PUT-Motorsport/PUTM_EV_DRS_2025/README.md

# PUTM_EV_DRS_2024
 Drs (active aero) project for PUT Motorsport
