PUT-Motorsport/PUTM_EV_DRS_2025/documentation/STM-pinout.png

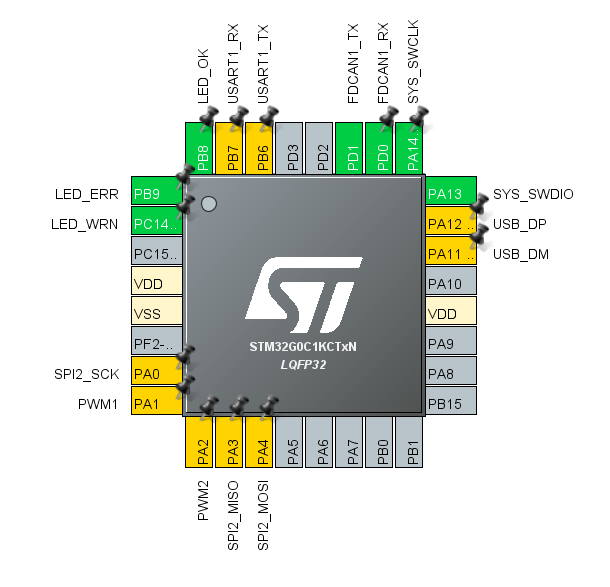
documentation/STM-pinout.png
