PUT-Motorsport/PUTM_EV_DRS_2025/documentation/WBDesignSpec_5V.png

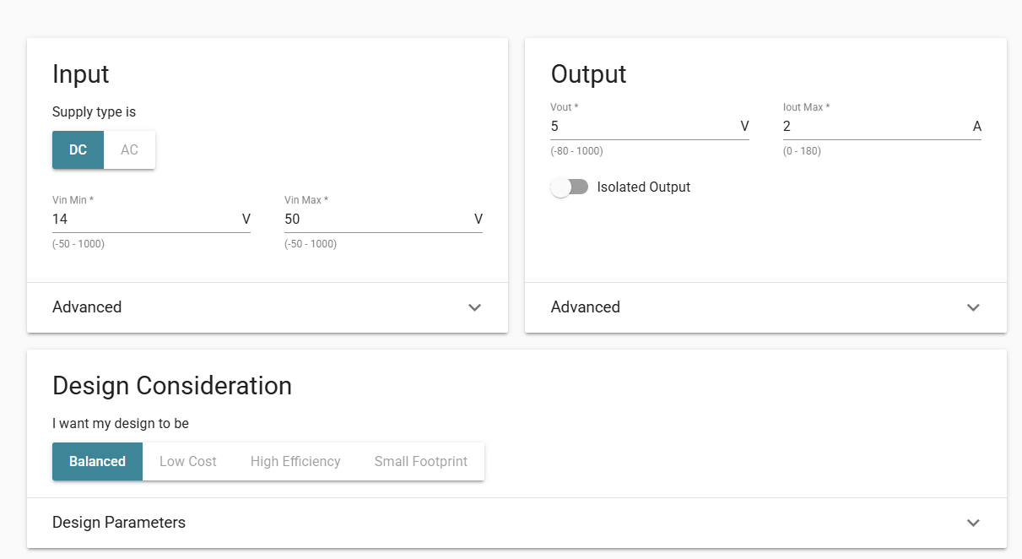
documentation/WBDesignSpec_5V.png
