PUT-Motorsport/PUTM_EV_DRS_2025/documentation/WBDesignSpec_6V6.png

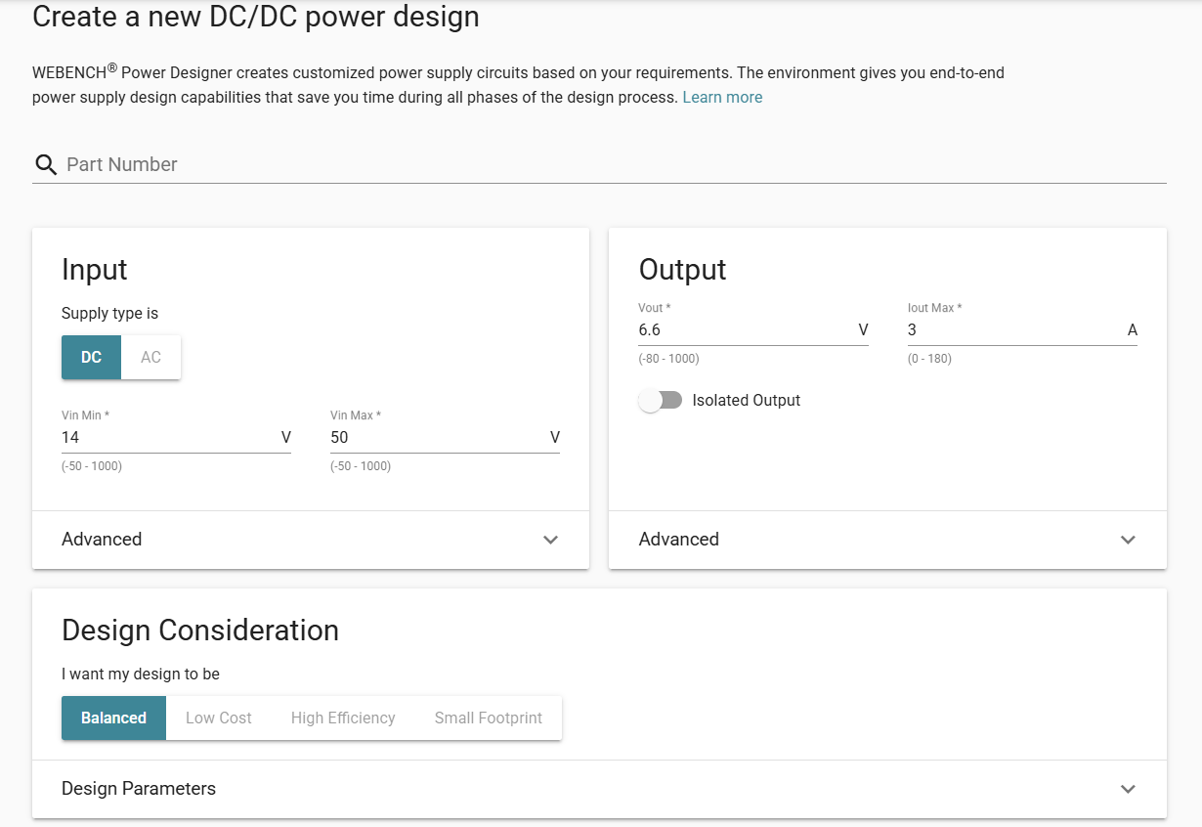
documentation/WBDesignSpec_6V6.png
