PUT-Motorsport/PUTM_EV_DRS_2025/documentation/WBBOMDesignLMR51635DDC.csv

Part | Manufacturer | Part Number | Quantity | Price ($) | Footprint (mm²) | Description
Cout | MuRata | GRM32ER61C476KE15L | 2 | 0.17 | 14.7 | Cap: 47 µF Total Derated Cap: 51 µF VDC: 16 V ESR: 3.04 mΩ Package: 1210
Cinx | MuRata | GRM188R72A104KA35D | 1 | 0.04 | 4.68 | Cap: 100 nF Total Derated Cap: 48 nF VDC: 100 V ESR: 1 mΩ Package: 0603
L1 | Bourns | SRR1208-120ML | 1 | 0.56 | 216.09 | L: 12 µH DCR: 25 mΩ IDC: 6.5 A
U1 | Texas Instruments | LMR51635DDC | 1 | 0.7 | 10.14
Cboot | MuRata | GRM155R71C104KA88D | 1 | 0.01 | 3 | Cap: 100 nF Total Derated Cap: 100 nF VDC: 16 V ESR: 1 mΩ Package: 0402
Cin | TDK | C3216X7R2A105K160AA | 3 | 0.11 | 10.92 | Cap: 1 µF Total Derated Cap: 1.5 µF VDC: 100 V ESR: 4.58 mΩ Package: 1206_180
Rfbb | Vishay-Dale | CRCW060313K7FKEA | 1 | 0.01 | 4.68 | Resistance: 13.7 kΩ Tolerance: 1.0% Power: 100 mW
Rfbt | Vishay-Dale | CRCW0402100KFKED | 1 | 0.01 | 3 | Resistance: 100 kΩ Tolerance: 1.0% Power: 63 mW
