PUT-Motorsport/PUTM_EV_DRS_2025/hardware/drs.kicad_pcb

## KiCad design hardware/drs.kicad_pcb (2025-05-21)

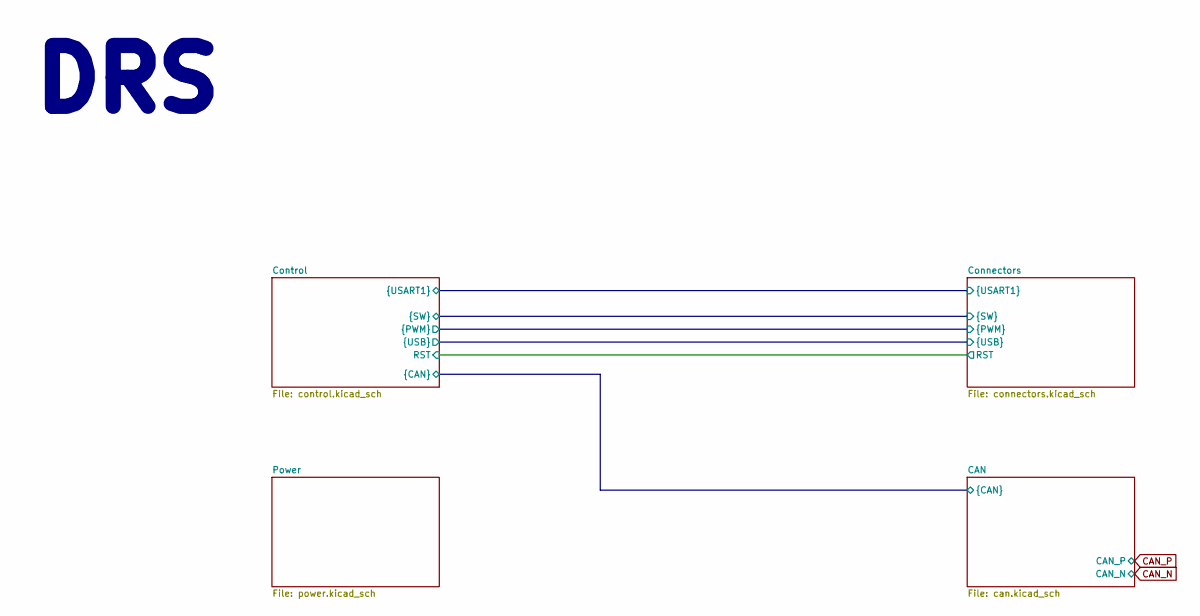
[picture p4: schematic drs.kicad_sch, DRS - Drag Reduction System]

Notes on the sheet:
DRS

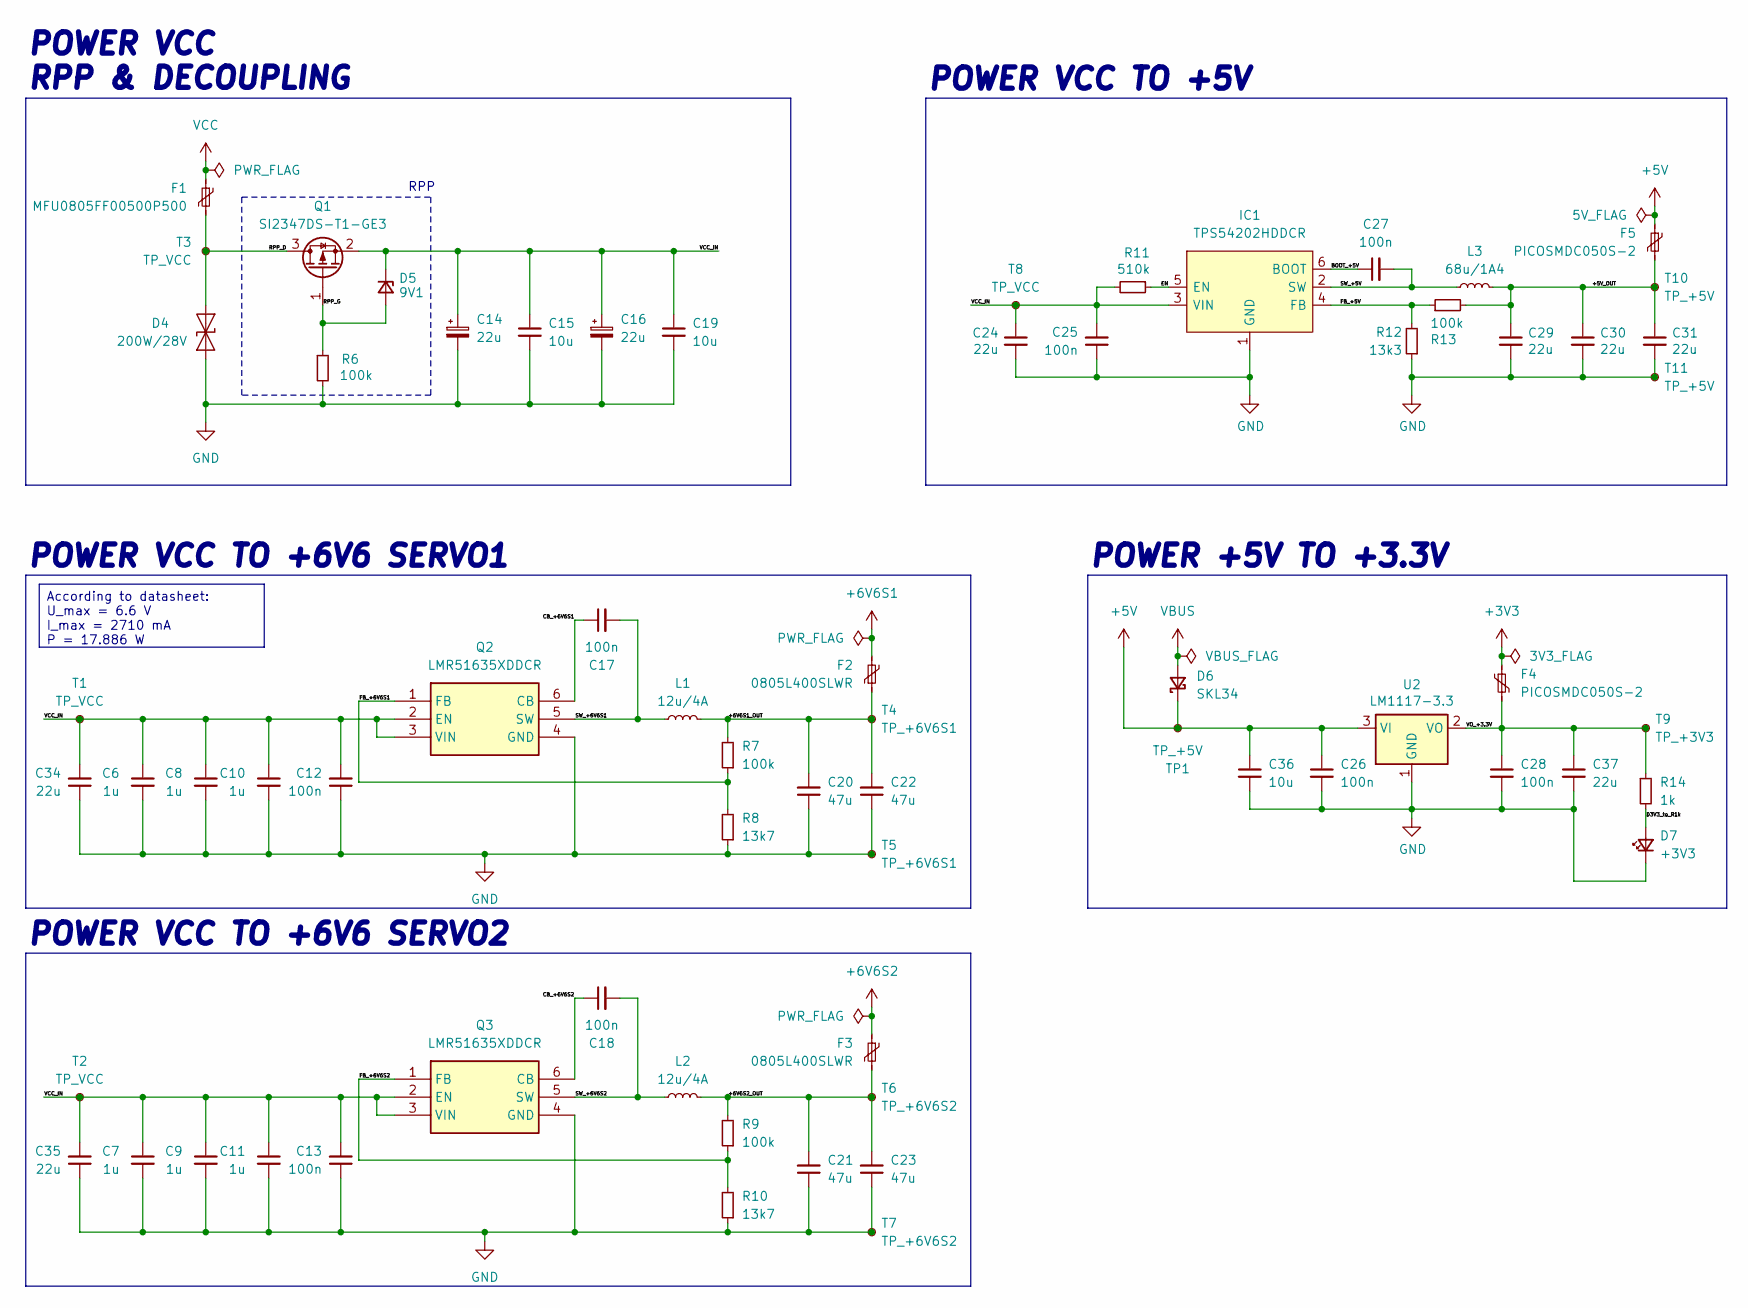
[picture p5: schematic power.kicad_sch, DRS - Drag Reduction System]

Parts:
C6, C7, C8, C9, C10, C11: 1u; C_0603_1608Metric_Pad1.08x0.95mm_HandSolder
C12, C13, C17, C18, C26, C27, C28: 100n; C_0603_1608Metric_Pad1.08x0.95mm_HandSolder
C14, C16: 22u; CP_Elec_4x5.8
C15, C19, C36: 10u; C_0603_1608Metric_Pad1.08x0.95mm_HandSolder
C20, C21, C22, C23: 47u; C_0805_2012Metric_Pad1.18x1.45mm_HandSolder
C24, C29, C30, C31: 22u; C_0805_2012Metric_Pad1.18x1.45mm_HandSolder; Manufacturer_Part_Number CL21A107MQYNNWE; Mouser Part Number 810-C2012X5R1V226MAC
C25: 100n; C_0603_1608Metric_Pad1.08x0.95mm_HandSolder; Manufacturer_Part_Number C0603C104J3RACTU; Mouser Part Number 80-C0603C104J3R
C34, C35, C37: 22u; C_0805_2012Metric_Pad1.18x1.45mm_HandSolder
D4: 200W/28V; D_SOD-123
D5: 9V1; D_SOD-323_HandSoldering
D6: SKL34; D_SOD-123F
D7: +3V3; LED_0603_1608Metric_Pad1.05x0.95mm_HandSolder
F1: MFU0805FF00500P500; Fuse_0805_2012Metric_Pad1.15x1.40mm_HandSolder
F2, F3: 0805L400SLWR; Fuse_0805_2012Metric_Pad1.15x1.40mm_HandSolder
F4, F5: PICOSMDC050S-2; Fuse_0805_2012Metric_Pad1.15x1.40mm_HandSolder
IC1: TPS54202HDDCR; SOT-23-6_Handsoldering; Mouser Part Number 595-TPS54202HDDCR
L1, L2: 12u/4A; L_Bourns_SRN6045TA
L3: 68u/1A4; L_TDK_VLS6045EX_VLS6045AF; Mouser Part Number 810-VLS6045EX-680M
Q1: SI2347DS-T1-GE3; SOT-23-3
Q2, Q3: LMR51635XDDCR; SOT-23-6_Handsoldering; Manufacturer_Part_Number LMR51635XDDCR
R6, R7, R9: 100k; R_0603_1608Metric_Pad0.98x0.95mm_HandSolder
R8, R10: 13k7; R_0603_1608Metric_Pad0.98x0.95mm_HandSolder
R11: 510k; R_0603_1608Metric_Pad0.98x0.95mm_HandSolder; Manufacturer_Part_Number RT0603DRD07510KL; Mouser Part Number 603-RT0603DRD07510KL
R12: 13k3; R_0603_1608Metric_Pad0.98x0.95mm_HandSolder; Manufacturer_Part_Number RT0603DRE0713K3L; Mouser Part Number 603-RT0603DRE0713K3L
R13: 100k; R_0603_1608Metric_Pad0.98x0.95mm_HandSolder; Manufacturer_Part_Number RT0603DRE07100KL; Mouser Part Number 603-RT0603DRE07100KL
R14: 1k; R_0603_1608Metric_Pad0.98x0.95mm_HandSolder
T1, T2, T3, T8: TP_VCC; TestPoint_Pad_1.0x1.0mm
T4, T5: TP_+6V6S1; TestPoint_Pad_1.0x1.0mm
T6, T7: TP_+6V6S2; TestPoint_Pad_1.0x1.0mm
T9: TP_+3V3; TestPoint_Pad_1.0x1.0mm
T10, T11: TP_+5V; TestPoint_Pad_1.0x1.0mm
TP1: TP_+5V; TestPoint_Pad_1.0x1.0mm
U2: LM1117-3.3; SOT-223-3_TabPin2

Connections:
+3V3: F4.1; also elsewhere on the board
+5V: C26.1, C36.1, D6.1 (K), F5.1, TP1.1, U2.3 (VI); also elsewhere on the board
+6V6S1: F2.2; also elsewhere on the board
+6V6S2: F3.1; also elsewhere on the board
/Power/+5V_OUT: C29.1, C30.1, C31.1, F5.2, L3.2, R13.2, T10.1
/Power/+6V6S1_OUT: C20.2, C22.2, F2.1, L1.2, R7.2, T4.1
/Power/+6V6S2_OUT: C21.2, C23.2, F3.2, L2.2, R9.2, T6.1
/Power/BOOT_+5V: C27.1, IC1.6 (BOOT)
/Power/CB_+6V6S1: C17.1, Q2.6 (CB)
/Power/CB_+6V6S2: C18.1, Q3.6 (CB)
/Power/D3V3_to_R1k: D7.2 (A), R14.2
/Power/EN: IC1.5 (EN), R11.1
/Power/FB_+5V: IC1.4 (FB), R12.2, R13.1
/Power/FB_+6V6S1: Q2.1 (FB), R7.1, R8.2
/Power/FB_+6V6S2: Q3.1 (FB), R9.1, R10.2
/Power/RPP_D: D4.2 (A2), F1.2, Q1.3 (D), T3.1
/Power/RPP_G: D5.2 (A), Q1.1 (G), R6.1
/Power/SW_+5V: C27.2, IC1.2 (SW), L3.1
/Power/SW_+6V6S1: C17.2, L1.1, Q2.5 (SW)
/Power/SW_+6V6S2: C18.2, L2.1, Q3.5 (SW)
/Power/VCC_IN: C6.1, C7.1, C8.1, C9.1, C10.1, C11.1, C12.2, C13.2, C14.1, C15.1, C16.1, C19.1, C24.1, C25.2, C34.2, C35.2, D5.1 (K), IC1.3 (VIN), Q1.2 (S), Q2.2 (EN), Q2.3 (VIN), Q3.2 (EN), Q3.3 (VIN), R11.2, T1.1, T2.1, T8.1
/Power/VO_+3.3V: C28.1, C37.1, F4.2, R14.1, T9.1, U2.2 (VO)
GND: C6.2, C7.2, C8.2, C9.2, C10.2, C11.2, C12.1, C13.1, C14.2, C15.2, C16.2, C19.2, C20.1, C21.1, C22.1, C23.1, C24.2, C25.1, C26.2, C28.2, C29.2, C30.2, C31.2, C34.1, C35.1, C36.2, C37.2, D4.1 (A1), D7.1 (K), IC1.1 (GND), Q2.4 (GND), Q3.4 (GND), R6.2, R8.1, R10.1, R12.1, T5.1, T7.1, T11.1, U2.1 (GND); also elsewhere on the board
VBUS: D6.2 (A); also elsewhere on the board
VCC: F1.1; also elsewhere on the board

Notes on the sheet:
RPP
POWER VCC TO +6V6 SERVO2
POWER VCC TO +5V
POWER +5V TO +3.3V
POWER VCC RPP & DECOUPLING
POWER VCC TO +6V6 SERVO1
According to datasheet: U_max = 6.6 V I_max = 2710 mA P = 17.886 W

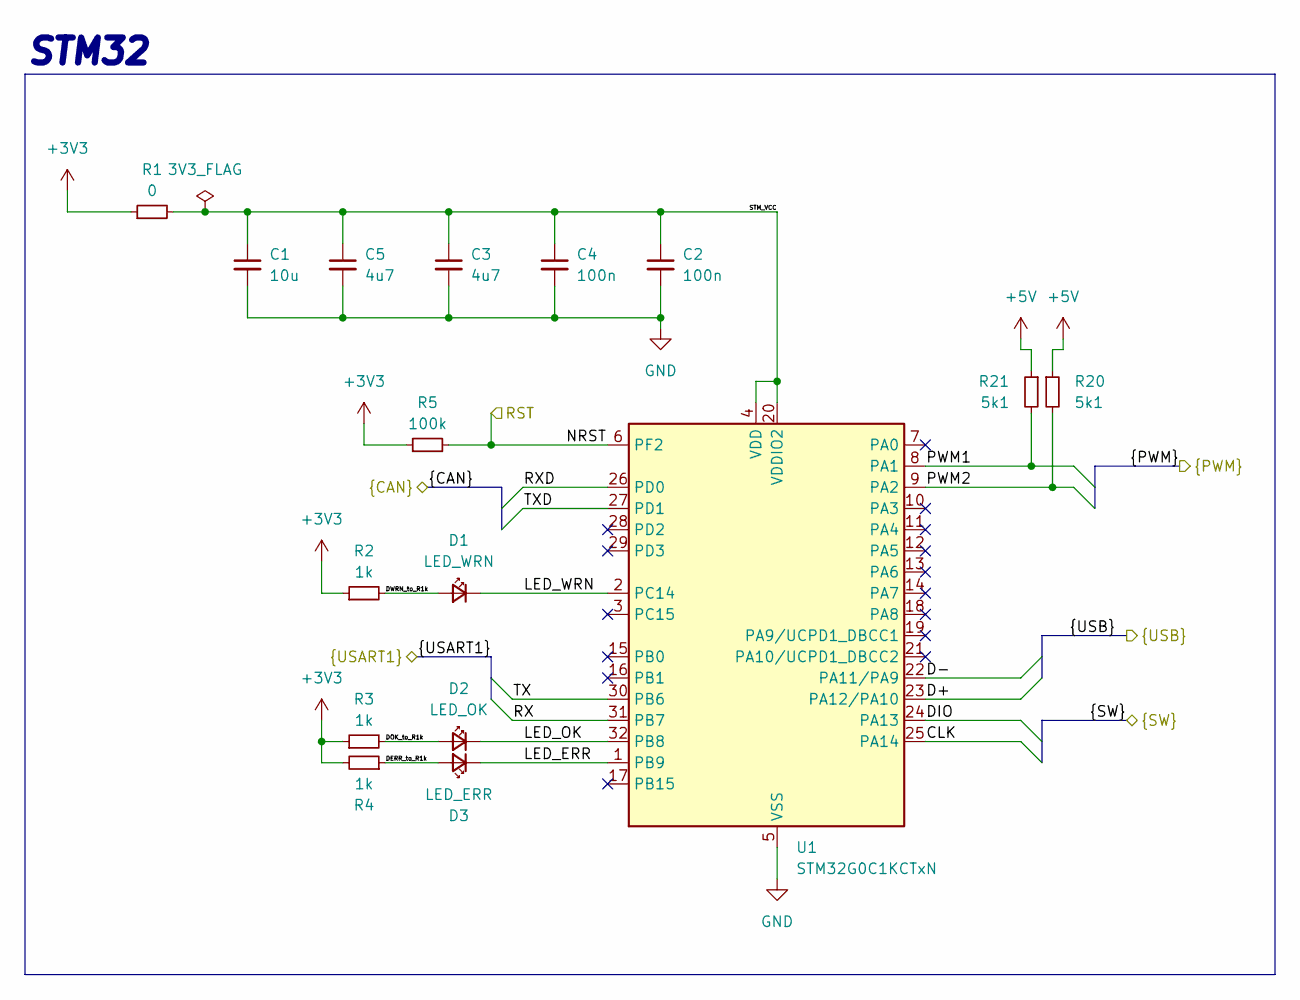
[picture p6: schematic control.kicad_sch, DRS - Drag Reduction System]

Parts:
C1: 10u; C_0603_1608Metric_Pad1.08x0.95mm_HandSolder
C2, C4: 100n; C_0603_1608Metric_Pad1.08x0.95mm_HandSolder
C3, C5: 4u7; C_0603_1608Metric_Pad1.08x0.95mm_HandSolder
D1: LED_WRN; LED_0603_1608Metric_Pad1.05x0.95mm_HandSolder
D2: LED_OK; LED_0603_1608Metric_Pad1.05x0.95mm_HandSolder
D3: LED_ERR; LED_0603_1608Metric_Pad1.05x0.95mm_HandSolder
R1: 0; R_0603_1608Metric_Pad0.98x0.95mm_HandSolder
R2, R3, R4: 1k; R_0603_1608Metric_Pad0.98x0.95mm_HandSolder
R5: 100k; R_0603_1608Metric_Pad0.98x0.95mm_HandSolder
R20, R21: 5k1; R_0603_1608Metric_Pad0.98x0.95mm_HandSolder
U1: STM32G0C1KCTxN; LQFP-32_7x7mm_P0.8mm

Connections:
+3V3: R1.1, R2.1, R3.1, R4.2, R5.1; also elsewhere on the board
+5V: R20.1, R21.1; also elsewhere on the board
/CAN/RXD: U1.26 (PD0); also elsewhere on the board
/CAN/TXD: U1.27 (PD1); also elsewhere on the board
/Connectors/CLK: U1.25 (PA14); also elsewhere on the board
/Connectors/D+: U1.23 (PA12/PA10); also elsewhere on the board
/Connectors/D-: U1.22 (PA11/PA9); also elsewhere on the board
/Connectors/DIO: U1.24 (PA13); also elsewhere on the board
/Connectors/PWM1: R21.2, U1.8 (PA1); also elsewhere on the board
/Connectors/PWM2: R20.2, U1.9 (PA2); also elsewhere on the board
/Connectors/RX: U1.31 (PB7); also elsewhere on the board
/Connectors/TX: U1.30 (PB6); also elsewhere on the board
/Control/DERR_to_R1k: D3.2 (A), R4.1
/Control/DOK_to_R1k: D2.2 (A), R3.2
/Control/DWRN_to_R1k: D1.2 (A), R2.2
/Control/LED_ERR: D3.1 (K), U1.1 (PB9)
/Control/LED_OK: D2.1 (K), U1.32 (PB8)
/Control/LED_WRN: D1.1 (K), U1.2 (PC14)
/Control/NRST: R5.2, U1.6 (PF2); also elsewhere on the board
/Control/STM_VCC: C1.1, C2.1, C3.1, C4.1, C5.1, R1.2, U1.4 (VDD), U1.20 (VDDIO2)
GND: C1.2, C2.2, C3.2, C4.2, C5.2, U1.5 (VSS); also elsewhere on the board

Notes on the sheet:
STM32

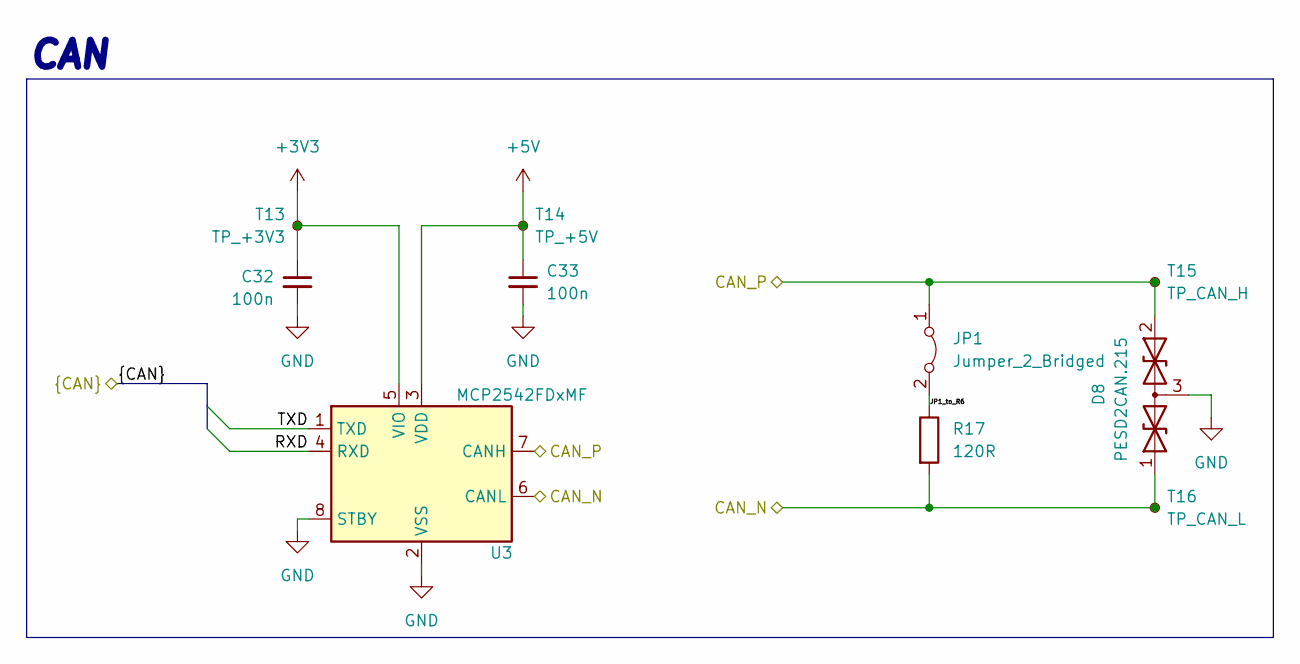
[picture p7: schematic can.kicad_sch, DRS - Drag Reduction System]

Parts:
C32, C33: 100n; C_0603_1608Metric_Pad1.08x0.95mm_HandSolder
D8: PESD2CAN.215; SOT-23-3
JP1: Jumper_2_Bridged; PinHeader_1x02_P2.54mm_Vertical
R17: 120R; R_0603_1608Metric_Pad0.98x0.95mm_HandSolder
T13: TP_+3V3; TestPoint_Pad_1.0x1.0mm
T14: TP_+5V; TestPoint_Pad_1.0x1.0mm
T15: TP_CAN_H; TestPoint_Pad_1.0x1.0mm
T16: TP_CAN_L; TestPoint_Pad_1.0x1.0mm
U3: MCP2542FDxMF; DFN-8-1EP_3x3mm_P0.65mm_EP1.55x2.4mm

Connections:
+3V3: C32.1, T13.1, U3.5 (VIO); also elsewhere on the board
+5V: C33.1, T14.1, U3.3 (VDD); also elsewhere on the board
/CAN/JP1_to_R6: JP1.2 (B), R17.1
/CAN/RXD: U3.4 (RXD); also elsewhere on the board
/CAN/TXD: U3.1 (TXD); also elsewhere on the board
CAN_N: D8.1 (A1), R17.2, T16.1, U3.6 (CANL); also elsewhere on the board
CAN_P: D8.2 (A2), JP1.1 (A), T15.1, U3.7 (CANH); also elsewhere on the board
GND: C32.2, C33.2, D8.3 (common), U3.2 (VSS), U3.8 (STBY), U3.9 (VSS); also elsewhere on the board

Notes on the sheet:
CAN

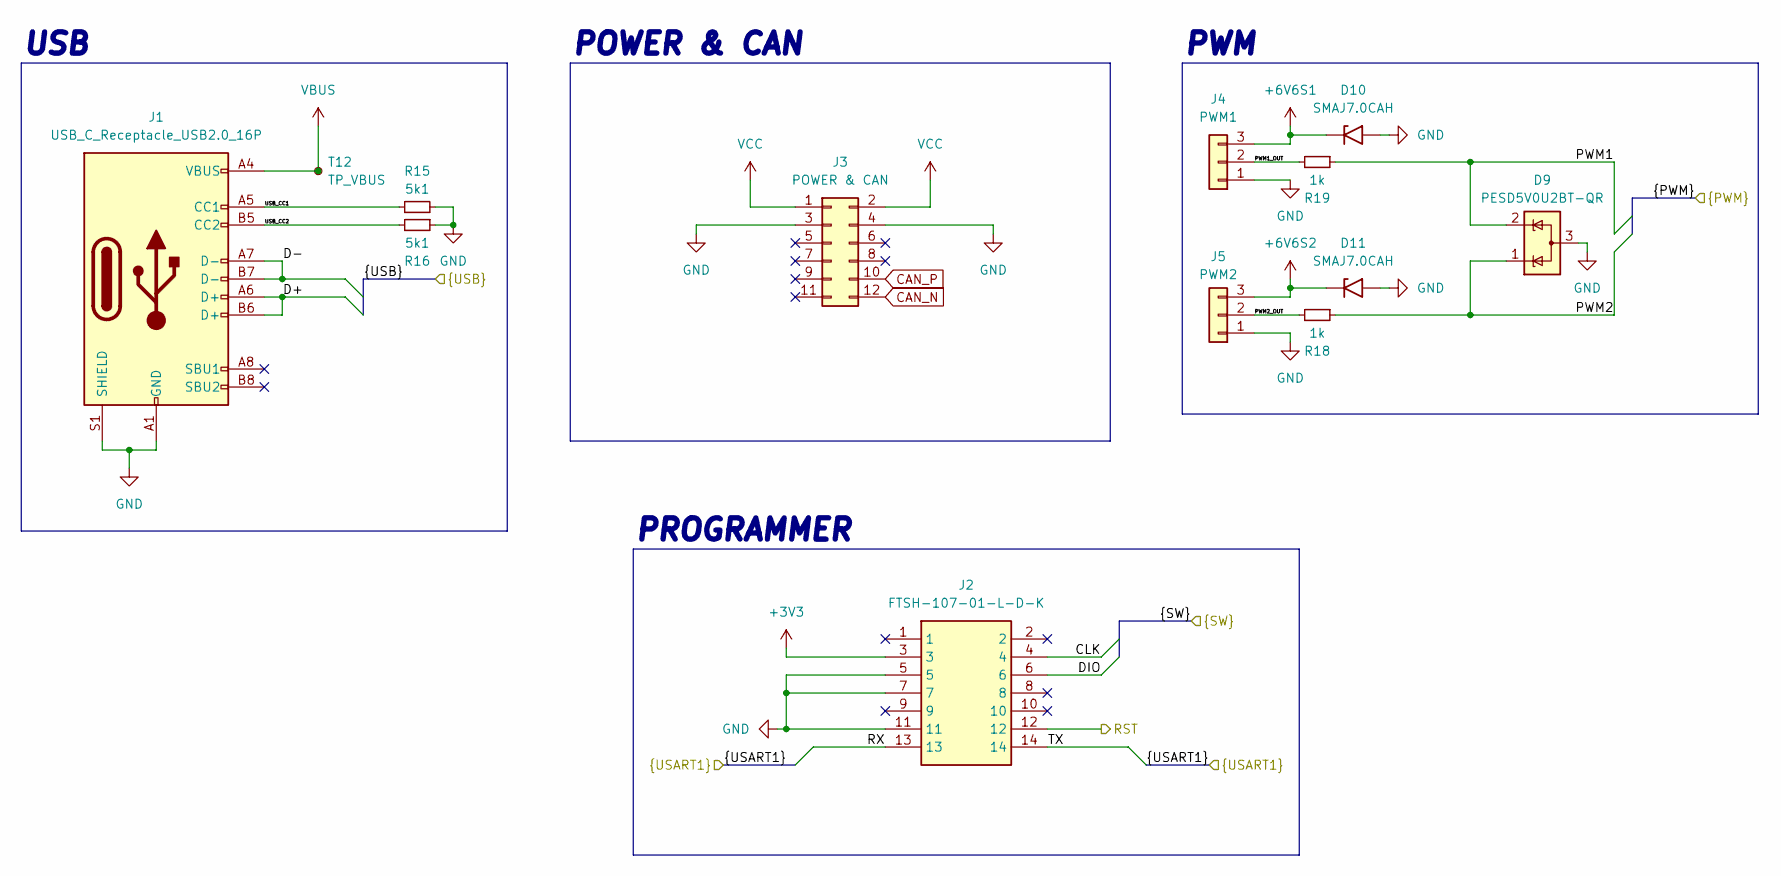
[picture p8: schematic connectors.kicad_sch, DRS - Drag Reduction System]

Parts:
D9: PESD5V0U2BT-QR; SOT-23-3
D10, D11: SMAJ7.0CAH; D_SMA_Handsoldering
J1: USB_C_Receptacle_USB2.0_16P; USB_C_Receptacle_GCT_USB4105-xx-A_16P_TopMnt_Horizontal
J2: FTSH-107-01-L-D-K; FTSH-107-XX-YYY-D-K; Mouser Part Number 200-FTSH10701LDK
J3: POWER & CAN; SHDR12W64P254X254_2X6_2286X895X915P
J4: PWM1; HDRV3W64P0X254_1X3_762X254X864P
J5: PWM2; HDRV3W64P0X254_1X3_762X254X864P
R15, R16: 5k1; R_0603_1608Metric_Pad0.98x0.95mm_HandSolder
R18, R19: 1k; R_0603_1608Metric_Pad0.98x0.95mm_HandSolder
T12: TP_VBUS; TestPoint_Pad_1.0x1.0mm

Connections:
+3V3: J2.3; also elsewhere on the board
+6V6S1: D10.1 (A1), J4.3; also elsewhere on the board
+6V6S2: D11.1 (A1), J5.3; also elsewhere on the board
/Connectors/CLK: J2.4; also elsewhere on the board
/Connectors/D+: J1.A6 (D+), J1.B6 (D+); also elsewhere on the board
/Connectors/D-: J1.A7 (D-), J1.B7 (D-); also elsewhere on the board
/Connectors/DIO: J2.6; also elsewhere on the board
/Connectors/PWM1: D9.2 (K), R19.1; also elsewhere on the board
/Connectors/PWM1_OUT: J4.2, R19.2
/Connectors/PWM2: D9.1 (K), R18.1; also elsewhere on the board
/Connectors/PWM2_OUT: J5.2, R18.2
/Connectors/RX: J2.13; also elsewhere on the board
/Connectors/TX: J2.14; also elsewhere on the board
/Connectors/USB_CC1: J1.A5 (CC1), R15.1
/Connectors/USB_CC2: J1.B5 (CC2), R16.2
/Control/NRST: J2.12; also elsewhere on the board
CAN_N: J3.12; also elsewhere on the board
CAN_P: J3.10; also elsewhere on the board
GND: D9.3 (A), D10.2 (A2), D11.2 (A2), J1.A1 (GND), J1.A12 (GND), J1.B1 (GND), J1.B12 (GND), J1.S1 (SHIELD), J2.5, J2.7, J2.11, J3.3, J3.4, J4.1, J5.1, R15.2, R16.1; also elsewhere on the board
VBUS: J1.A4 (VBUS), J1.A9 (VBUS), J1.B4 (VBUS), J1.B9 (VBUS), T12.1; also elsewhere on the board
VCC: J3.1, J3.2; also elsewhere on the board

Notes on the sheet:
PWM
PROGRAMMER
POWER & CAN
USB

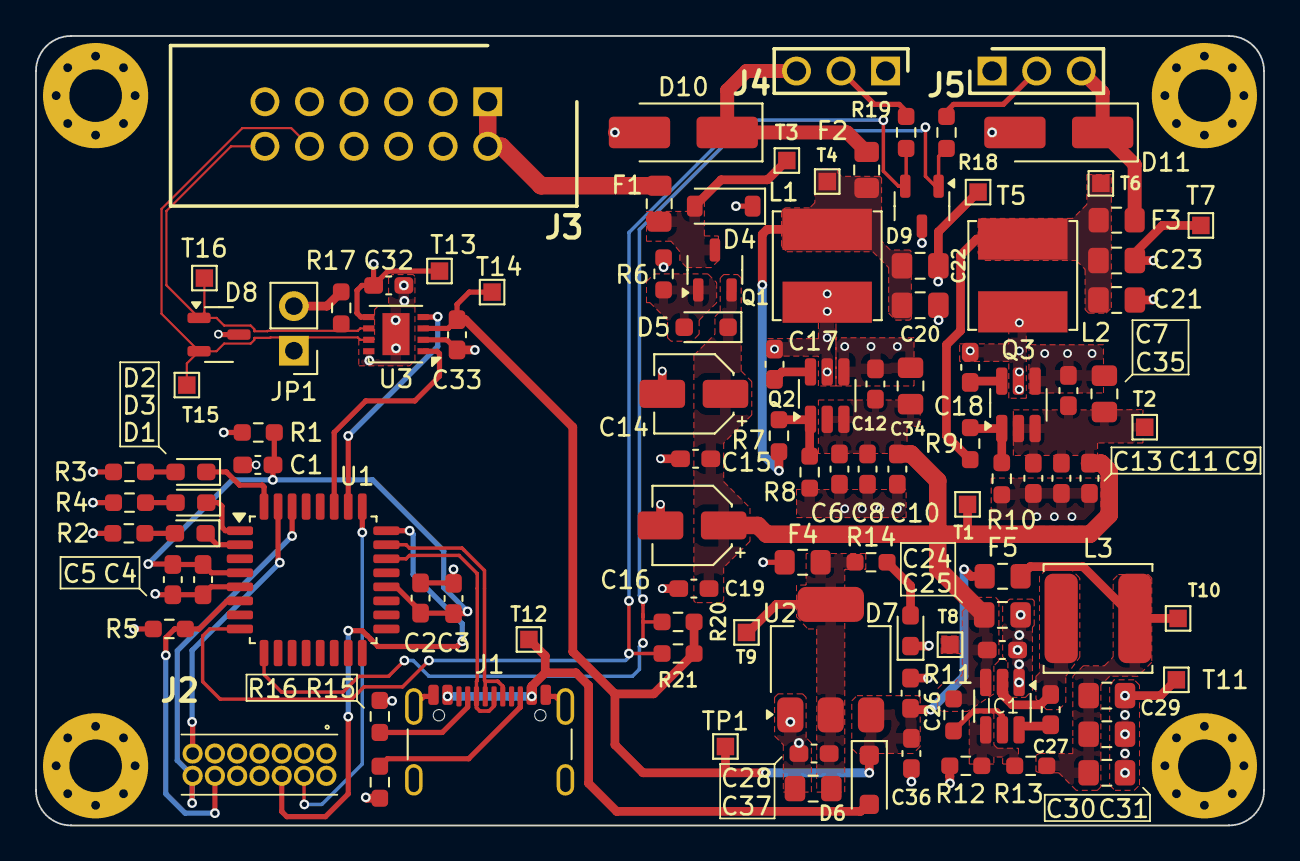
[picture p9: board drs.kicad_pcb from above]

Board: 4 copper layers, 70.0 x 45.0 mm, 107 parts (0 on the bottom side), 50 nets.
