PUT-Motorsport/PUTM_EV_DRS_2025/firmware/Core/Src/main.cpp

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
/* Includes ------------------------------------------------------------------*/
#include "main.h"

/* USER CODE BEGIN Includes */
#include <stdbool.h>
#include "CAN\lib\can_interface.hpp"
/* USER CODE END Includes */

/* USER CODE BEGIN PD */
#define BRAKE_THRESHOLD 100
#define SERVO_POSITION_OPEN 1000
#define SERVO_POSITION_NEUTRAL 1500
#define SERVO_POSITION_CLOSED 2000
/* USER CODE END PD */

FDCAN_HandleTypeDef hfdcan1;

TIM_HandleTypeDef htim2;
TIM_HandleTypeDef htim3;

UART_HandleTypeDef huart3;

/* USER CODE BEGIN PV */
bool drs_status = false;
uint16_t brakePressureFront = 0;
uint16_t brakePressureRear = 0;
/* USER CODE END PV */

void SystemClock_Config(void);
static void MX_GPIO_Init(void);
static void MX_TIM2_Init(void);
static void MX_FDCAN1_Init(void);
static void MX_USART3_UART_Init(void);
static void MX_TIM3_Init(void);
/**
  * @brief  The application entry point.
  * @retval int
  */
int main(void)
{

  /* MCU Configuration--------------------------------------------------------*/

  /* Reset of all peripherals, Initializes the Flash interface and the Systick. */
  HAL_Init();

  /* Configure the system clock */
  SystemClock_Config();

  /* Initialize all configured peripherals */
  MX_GPIO_Init();
  MX_TIM2_Init();
  MX_FDCAN1_Init();
  MX_USART3_UART_Init();
  MX_TIM3_Init();
  /* USER CODE BEGIN 2 */
  HAL_TIM_PWM_Start(&htim2, TIM_CHANNEL_3);
  HAL_FDCAN_Start(&hfdcan1);
  /* USER CODE END 2 */

  /* Infinite loop */
  /* USER CODE BEGIN WHILE */
  while (1)
  {
	  	  	  	  // LED TEST
//	  	  	  	  HAL_GPIO_TogglePin(LED_OK_GPIO_Port, LED_OK_Pin); // Toggle LED_OK
//	  	  	  	  HAL_Delay(500);
//	  	  	  	  HAL_GPIO_TogglePin(LED_ERR_GPIO_Port, LED_ERR_Pin);
//	  	  	  	  HAL_Delay(500);
//	  	  	  	  HAL_GPIO_TogglePin(LED_WRN_GPIO_Port, LED_WRN_Pin); // Toggle LED_WRN
//	  	  	  	  HAL_Delay(500);

	  	  	  	  // SERVO TEST 1
//	  	  	  	  __HAL_TIM_SET_COMPARE(&htim2, TIM_CHANNEL_3, SERVO_POSITION_NEUTRAL); //NEUTRAL
//	  	  	  	  HAL_Delay(2000);
//	  	  	  	  __HAL_TIM_SET_COMPARE(&htim2, TIM_CHANNEL_3, SERVO_POSITION_OPEN); //MAX
//	  	  	  	  HAL_Delay(2000);
	  	  	  	  // SERVO & DIODE TEST
//	  	  		  __HAL_TIM_SET_COMPARE(&htim2, TIM_CHANNEL_3, 3700); //MIN
//	  	  		  HAL_GPIO_TogglePin(LED_OK_GPIO_Port, LED_OK_Pin);
//	  	  		  HAL_Delay(1000);
//	  	  		  __HAL_TIM_SET_COMPARE(&htim2, TIM_CHANNEL_3, 6818); //NEUTRAL BY CALCULATIONS
//	  	  		  HAL_GPIO_TogglePin(LED_ERR_GPIO_Port, LED_ERR_Pin);
//	  	  		  HAL_Delay(1000);
	  	  	  	  // CAN
	  	  	  	  if(PUTM_CAN::can.get_driver_input_main_new_data())
	  	  	  	  {
	  	  	  		  auto driver_input_data = PUTM_CAN::can.get_driver_input_main();
	  	  	  		  brakePressureFront = driver_input_data.brakePressureFront;
	  	  	  		  brakePressureRear = driver_input_data.brakePressureRear;
	  	  	  	  }
	  	  	  	  // Tu masz ustawic odpowiedni warunek otworzenia lotki
	  	  	  	  // drs ON + brak hamowania!!!!!!!!!!!!!!!!!!!!!!!!!!!!!
	  	  	  	  if(drs_status)
	  	  	  	  {
	  	  	  		  HAL_GPIO_WritePin(LED_OK_GPIO_Port, LED_OK_Pin, GPIO_PIN_RESET);
	  	  	  		  __HAL_TIM_SET_COMPARE(&htim2, TIM_CHANNEL_3, SERVO_POSITION_NEUTRAL);
	  	  	  	  }
	  	  	  	  else
	  	  	  	  {
	  	  	  		  HAL_GPIO_WritePin(LED_ERR_GPIO_Port, LED_ERR_Pin, GPIO_PIN_RESET);
	  	  	  		  __HAL_TIM_SET_COMPARE(&htim2, TIM_CHANNEL_3, SERVO_POSITION_CLOSED);
	  	  	  	  }
//	  	  	  	  HAL_Delay(10);
    /* USER CODE END WHILE */

    /* USER CODE BEGIN 3 */
  }
  /* USER CODE END 3 */
}

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
