PUT-Motorsport/PUTM_EV_DRS_2025/firmware/drs.ioc

Mcu.UserName=STM32G0C1KCTxN
PA1.Signal=S_TIM2_CH2
PA2.Signal=S_TIM2_CH3
PA5.Signal=USART3_TX
PA7.Signal=S_TIM3_CH2
PB0.Signal=USART3_RX
PB8.GPIO_Label=LED_OK
PB8.Signal=GPIO_Output
PB9.GPIO_Label=LED_ERR
PB9.Signal=GPIO_Output
PD0.Signal=FDCAN1_RX
PD1.Signal=FDCAN1_TX
