PUT-Motorsport/PUTM_EV_DRS_2025/firmware/Core/Inc/main.h

#define LED_ERR_Pin GPIO_PIN_9
#define LED_ERR_GPIO_Port GPIOB
#define LED_WRN_Pin GPIO_PIN_14
#define LED_WRN_GPIO_Port GPIOC
#define LED_OK_Pin GPIO_PIN_8
#define LED_OK_GPIO_Port GPIOB
