PUT-Motorsport/PUTM_EV_DRS_2025/(commit log)

2025-01-09 DRS-first commit
    [can.kicad_sch, connectors.kicad_sch, control.kicad_sch, drs.kicad_sch, power.kicad_sch, servo.kicad_sch]
2025-01-14 added sheet pins
    [WBBOMDesignLMR38020FDDAR_5V.csv, can.kicad_sch, control.kicad_sch, drs.kicad_sch, power.kicad_sch, programator.kicad_sch, usb.kicad_sch]
2025-01-14 documentation update
    [WBBOMDesignLM5146RGYR_8V4.csv, power.kicad_sch]
2025-01-21 added 6V6 for servo
    [WBBOMDesignLM5146RGYR_8V4.csv, WBBOMDesignLMR51635DDC.csv, can.kicad_sch, power.kicad_sch]
2025-01-21 power labels corrected
    [power.kicad_sch]
2025-01-21 connectors - added, buses - todo
    [can.kicad_sch, connectors.kicad_sch, control.kicad_sch, drs.kicad_sch, power.kicad_sch, programator.kicad_sch]
2025-02-11 Poprawione busy, brak errorow
    [can.kicad_sch, connectors.kicad_sch, control.kicad_sch, drs.kicad_sch, power.kicad_sch, programator.kicad_sch]
2025-02-18 Footprints addes beside PWM connectors
    [can.kicad_sch, connectors.kicad_sch, control.kicad_sch, drs.kicad_sch, power.kicad_sch]
2025-02-18 PWM conns added
    [connectors.kicad_sch]
2025-02-19 Table updated- fuses and conns still not added
    [can.kicad_sch, connectors.kicad_sch, control.kicad_sch, power.kicad_sch]
2025-02-19 All footprints added
    [connectors.kicad_sch, power.kicad_sch]
2025-03-09 pcb scheme update - general/basic aligment
    [can.kicad_sch, connectors.kicad_sch, control.kicad_sch, drs.kicad_pcb, drs.kicad_sch, power.kicad_sch]
2025-03-17 Items assebled
    [can.kicad_sch, connectors.kicad_sch, drs.kicad_pcb, power.kicad_sch]
2025-03-25 Wszystkie elementy poukładane według dokumentacji na pod-grupy
    [drs.kicad_pcb]
2025-03-25 nowy uklad
    [drs.kicad_pcb]
2025-04-01 schematic & pcb update
    [can.kicad_sch, connectors.kicad_sch, control.kicad_sch, drs.kicad_pcb, power.kicad_sch]
2025-04-02 schematic & pcb udpate
    [drs.kicad_pcb, power.kicad_sch]
2025-04-05 pcb update
    [drs.kicad_pcb]
2025-04-05 signal routing
    [drs.kicad_pcb]
2025-04-05 usbc changed, foots for electro cap and +5 lay
    [connectors.kicad_sch, drs.kicad_pcb, power.kicad_sch]
2025-04-06 pcb & footprint update
    [connectors.kicad_sch, control.kicad_sch, drs.kicad_pcb, power.kicad_sch]
2025-04-06 d4 - footprint change
    [drs.kicad_pcb, power.kicad_sch]
2025-04-06 VCC to RPP & RPP to rest routing
    [drs.kicad_pcb, power.kicad_sch]
2025-04-08 pcb dp update
    [drs.kicad_pcb]
2025-04-08 pcb can & usb update
    [drs.kicad_pcb]
2025-04-10 pcb update - testpoints & 3V3
    [can.kicad_sch, connectors.kicad_sch, drs.kicad_pcb]
2025-05-05 silkscreen update
    [drs.kicad_pcb]
2025-05-06 pcb & scheme update
    [connectors.kicad_sch, drs.kicad_pcb]
2025-05-07 psb & schematic update
    [control.kicad_sch, drs.kicad_pcb]
2025-05-21 Added author on pcb
    [can.kicad_sch, connectors.kicad_sch, control.kicad_sch, drs.kicad_pcb, drs.kicad_sch, power.kicad_sch]
2025-05-28 Add CAN data receive
    *Issue with lib include
    [main.cpp]
2025-08-15 kwazer nie pokazuje bledu - servo dalej nie dziala
